svatoun/Reflexshield/board/deska.png

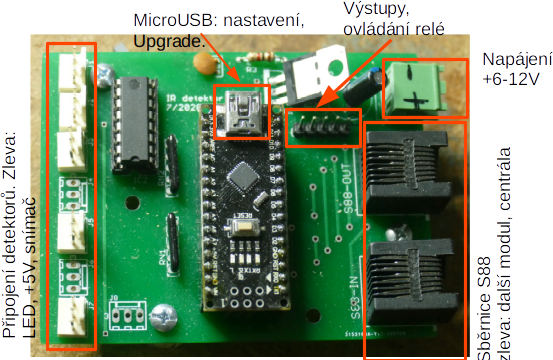
board/deska.png
