svatoun/Reflexshield/board/opto5-narrow-full2.pdf

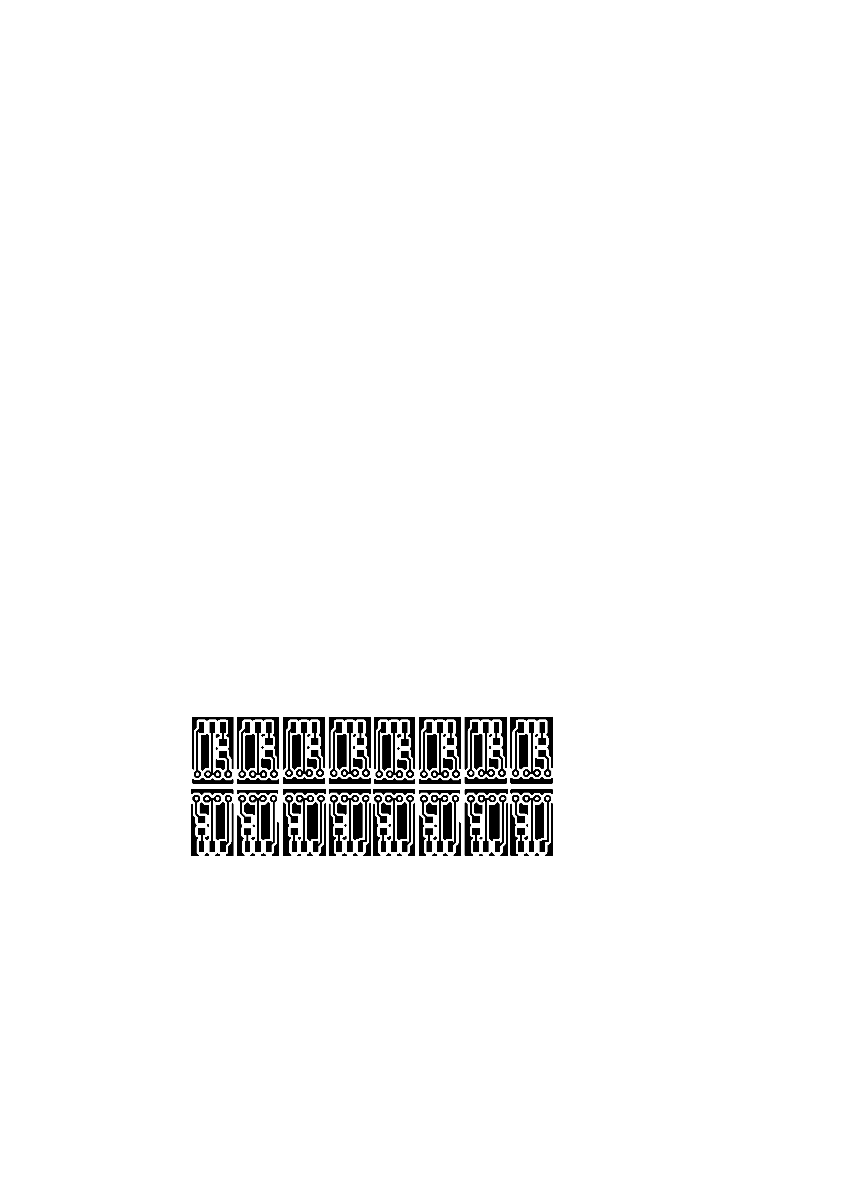
[picture p2: page 1]
