svatoun/Reflexshield/board/opto5-narrow.pdf

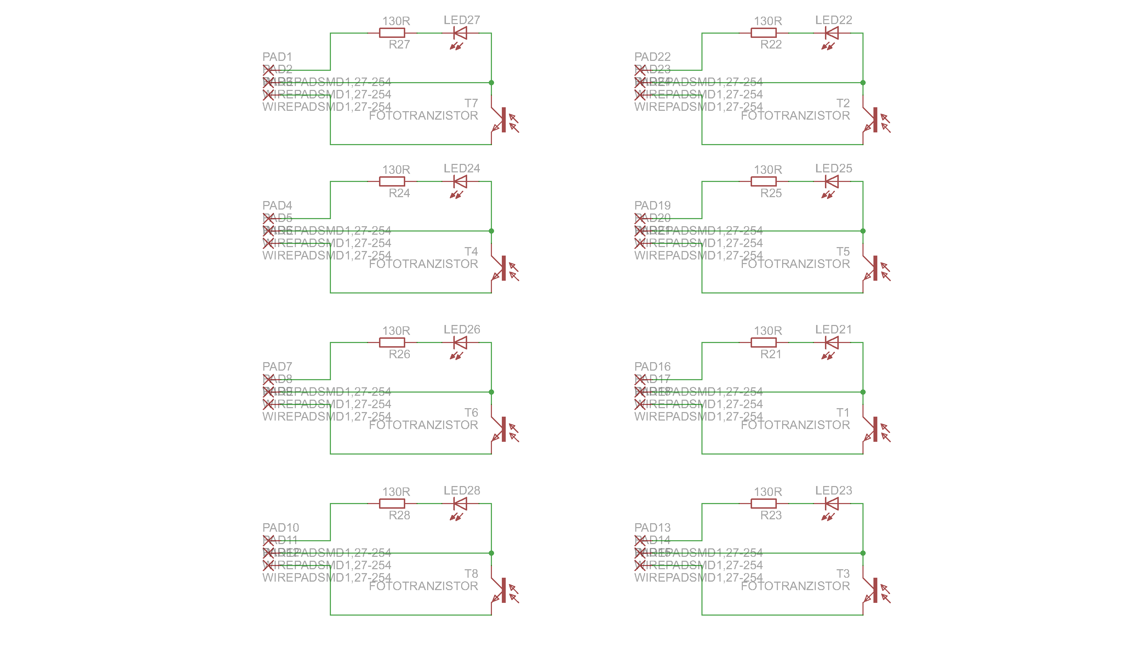
[picture p3: page 1]
