svatoun/Reflexshield/board/optoshield-low1-osaz2.pdf

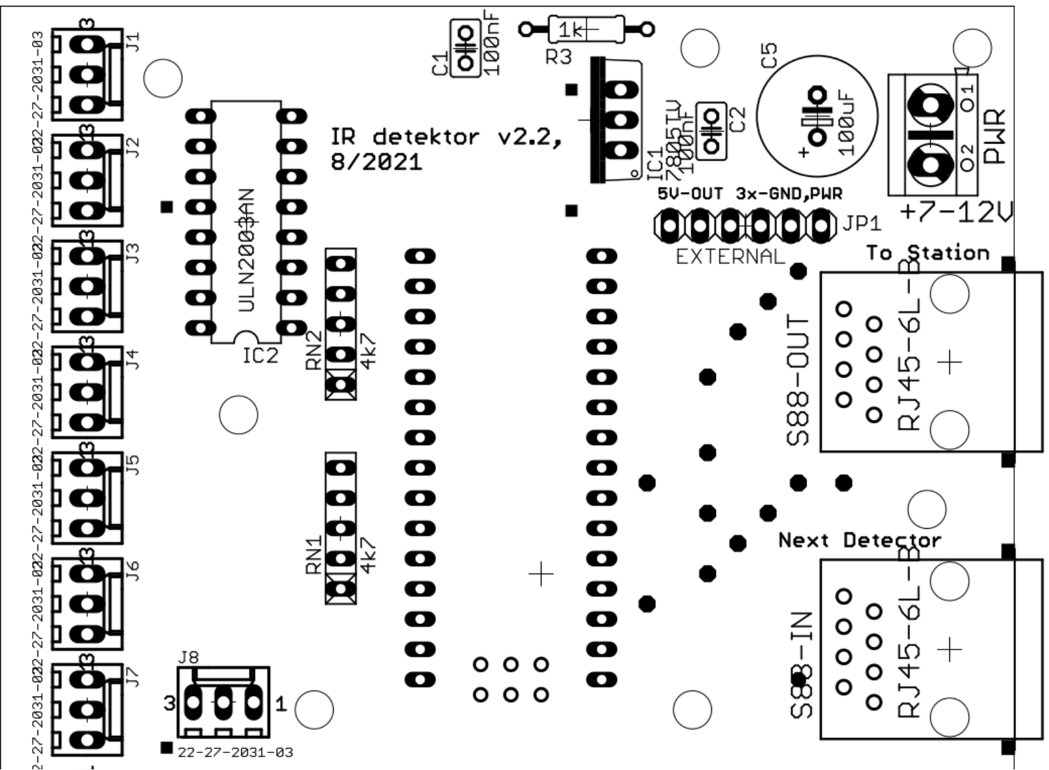
[picture p4: page 1]
