svatoun/Reflexshield/board/optoshield-low1-schema.pdf

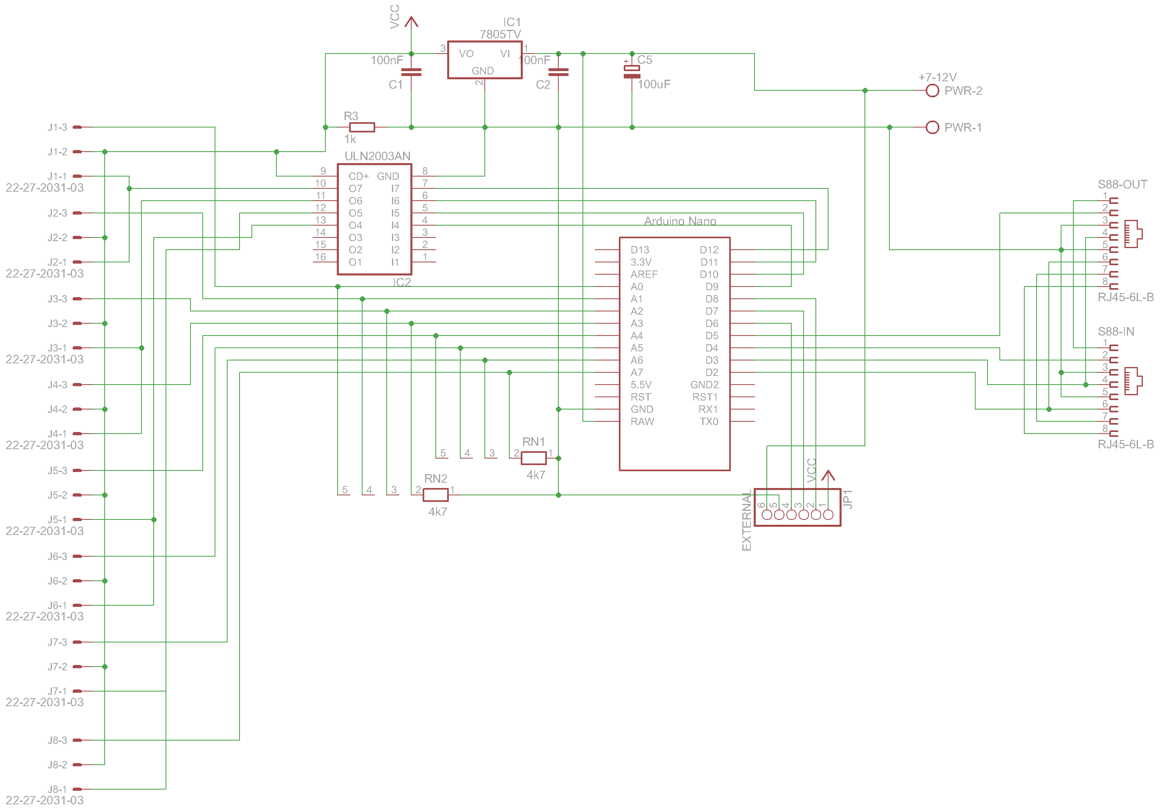
[picture p5: page 1]
