svatoun/Reflexshield/arduino/dva-senzory-enter.png

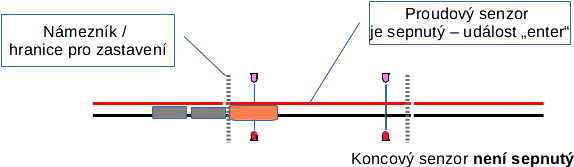
arduino/dva-senzory-enter.png
