svatoun/Reflexshield/arduino/dva-senzory-in.png

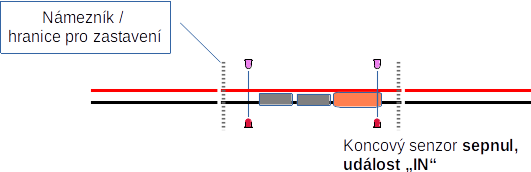
arduino/dva-senzory-in.png
