svatoun/Reflexshield/arduino/senzor-mezera.png

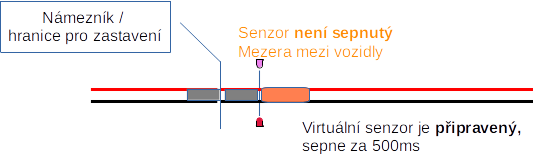
arduino/senzor-mezera.png
