svatoun/Reflexshield/arduino/senzor-najezd-soupravy.png

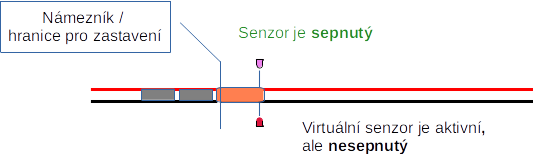
arduino/senzor-najezd-soupravy.png
