svatoun/Reflexshield/arduino/senzor-uvolnen.png

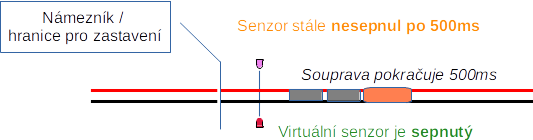
arduino/senzor-uvolnen.png
