svatoun/Reflexshield/arduino/senzor-za-poslednim.png

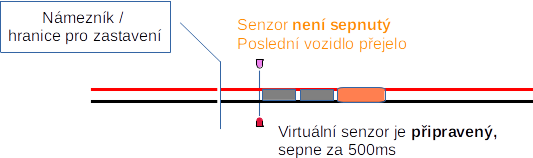
arduino/senzor-za-poslednim.png
