svatoun/Reflexshield/board/opto4-board.jpg

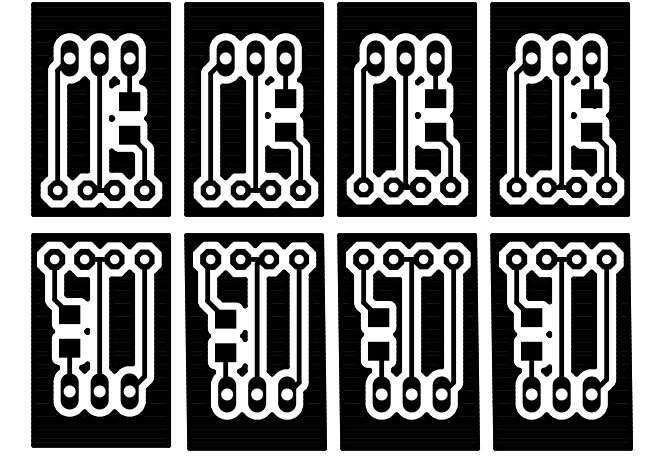
board/opto4-board.jpg
