svatoun/Reflexshield/board/opto4.png

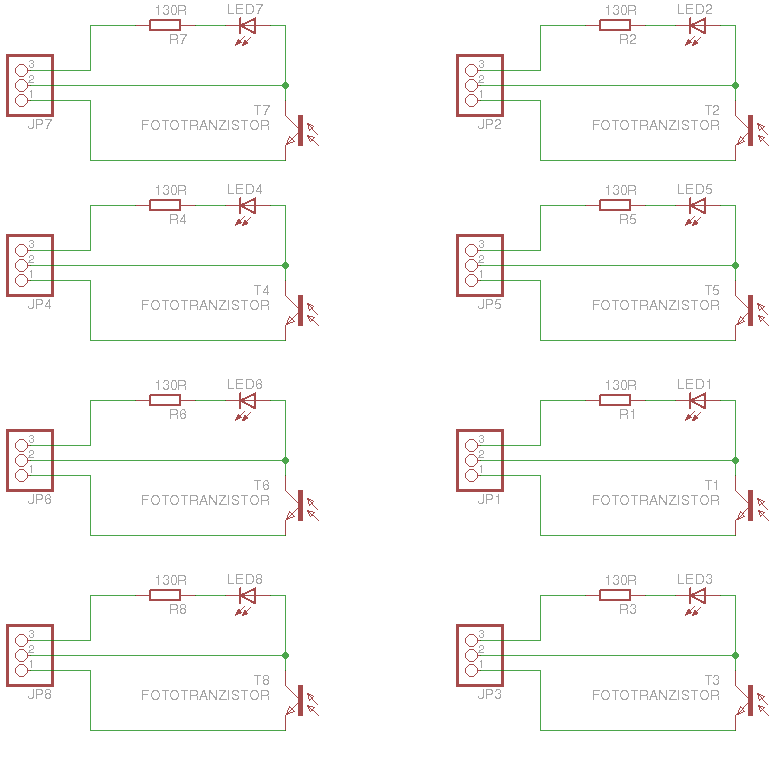
board/opto4.png
