svatoun/Reflexshield/board/optoshield-low1-board.png

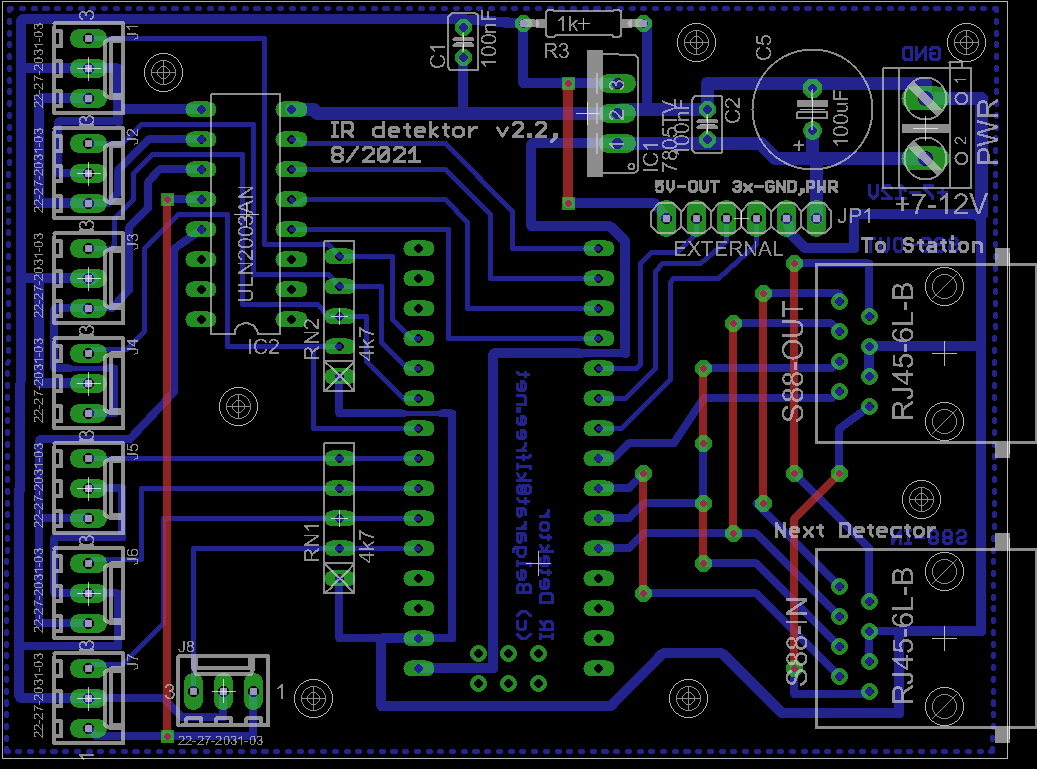
board/optoshield-low1-board.png
