svatoun/Reflexshield/board/optoshield-low1-osaz.jpg

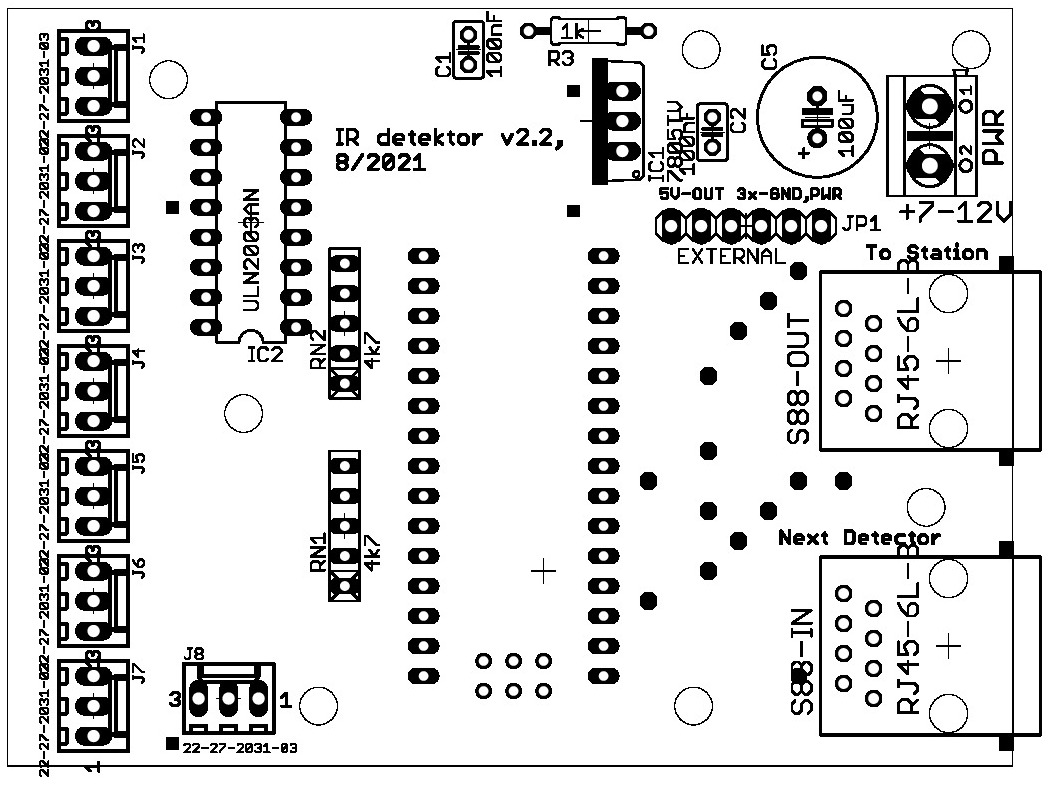
board/optoshield-low1-osaz.jpg
