svatoun/Reflexshield/board/optoshield-low1.jpg

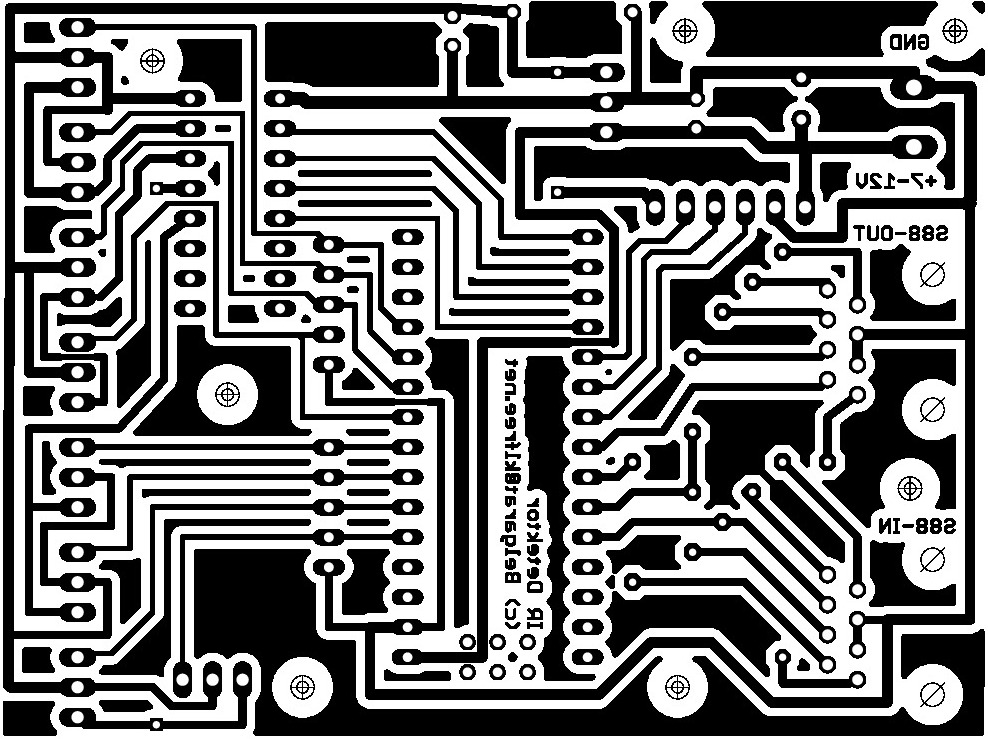
board/optoshield-low1.jpg
