svatoun/Reflexshield/board/Relayboard-board.jpg

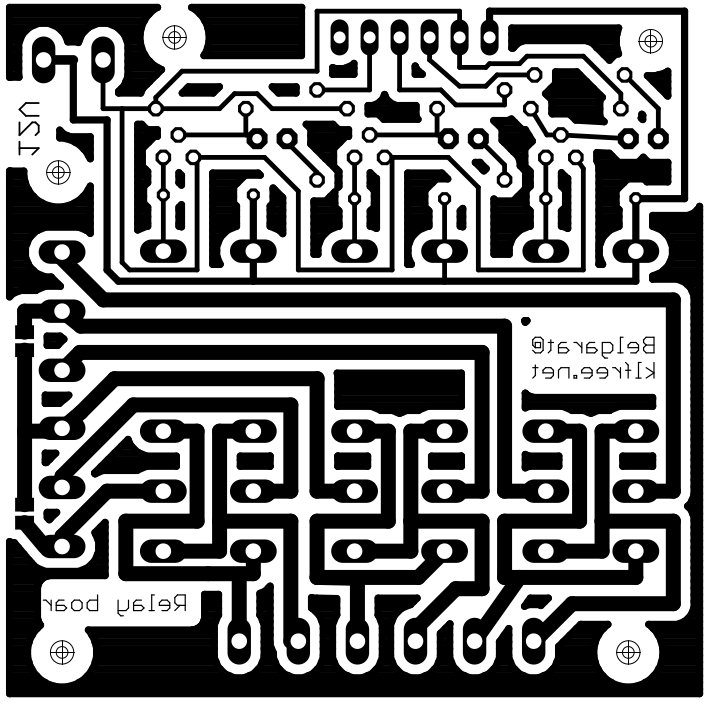
board/Relayboard-board.jpg
