svatoun/Reflexshield/board/Relayboard-schema.png

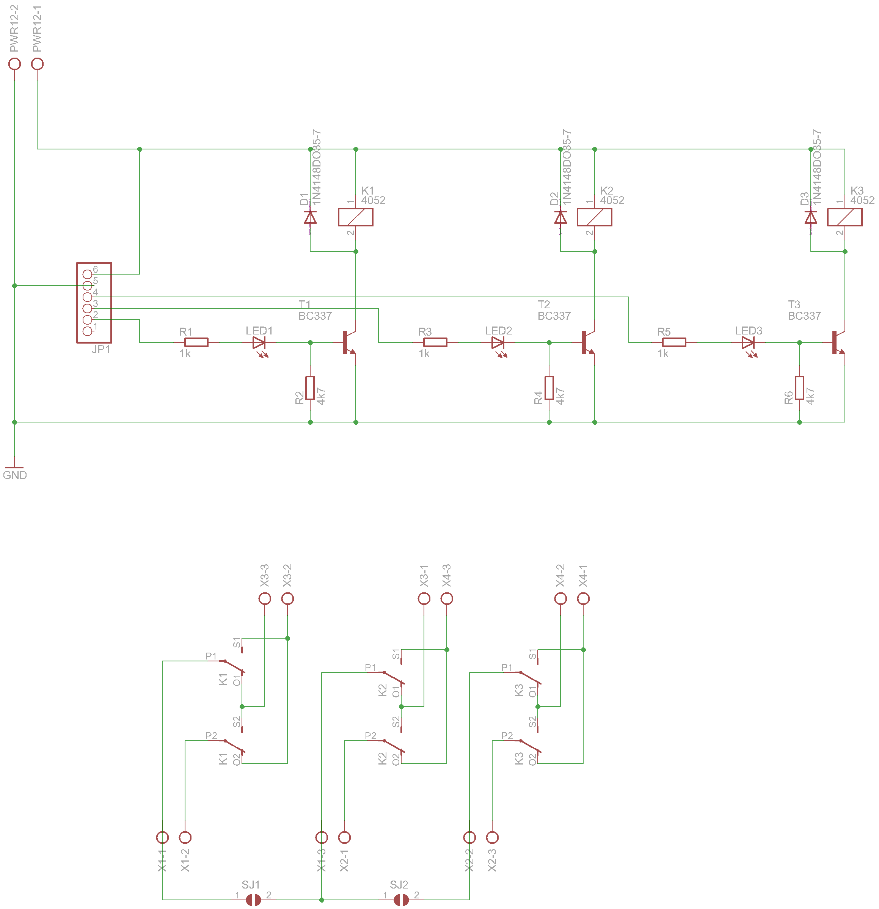
board/Relayboard-schema.png
