svatoun/Reflexshield/board/optoshield-low1.pdf

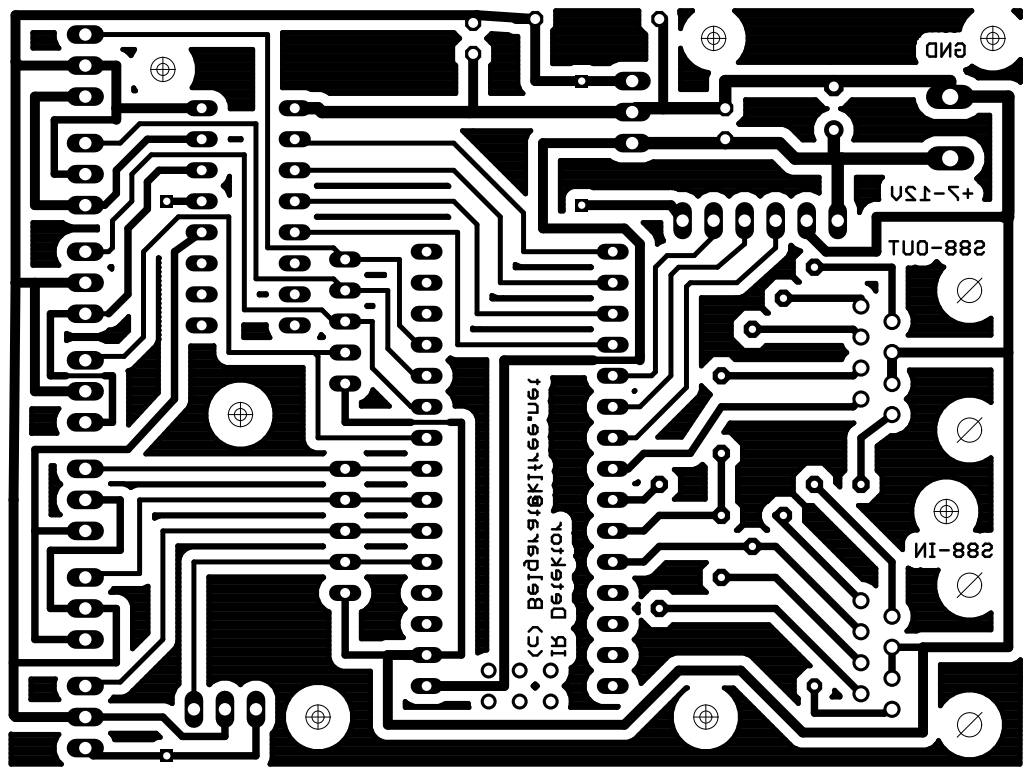
[picture p19: page 1]
