svatoun/Reflexshield/board/Relayboard.pdf

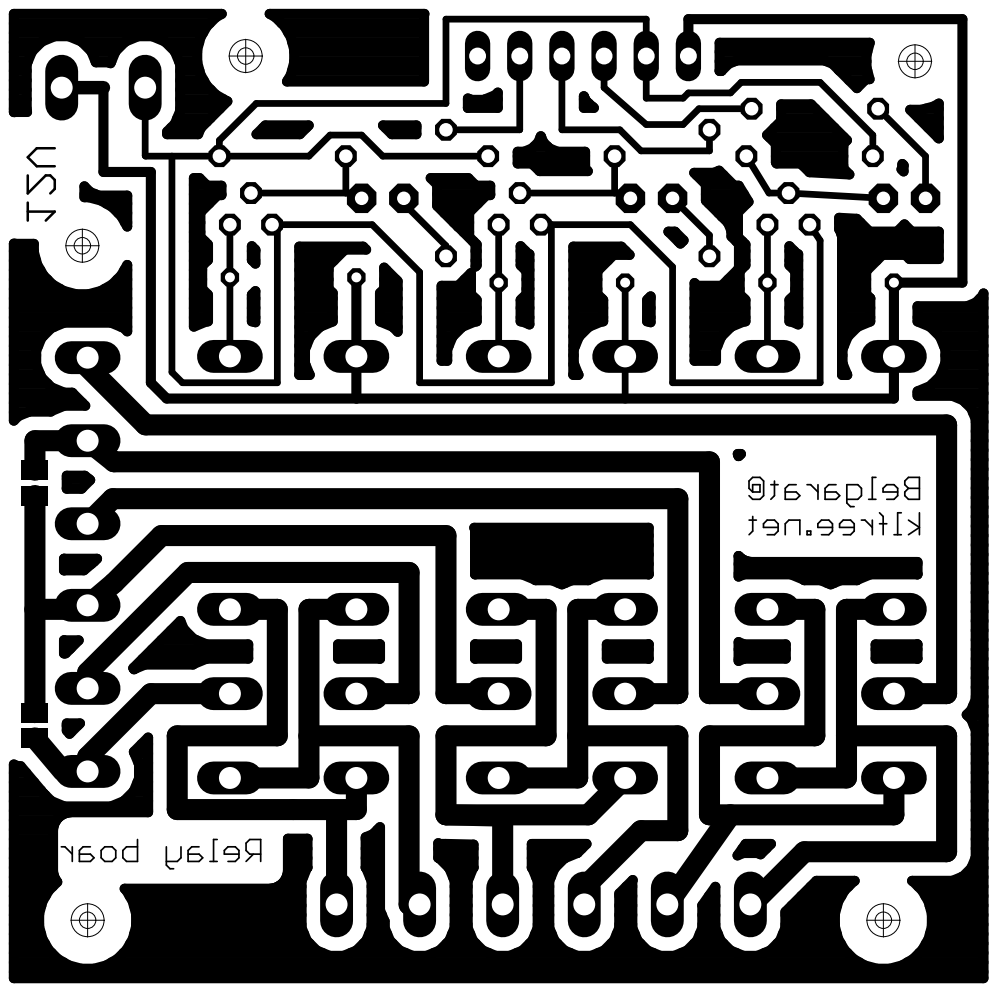
[picture p20: page 1]
