svatoun/Reflexshield/board/opto4-osaz.pdf

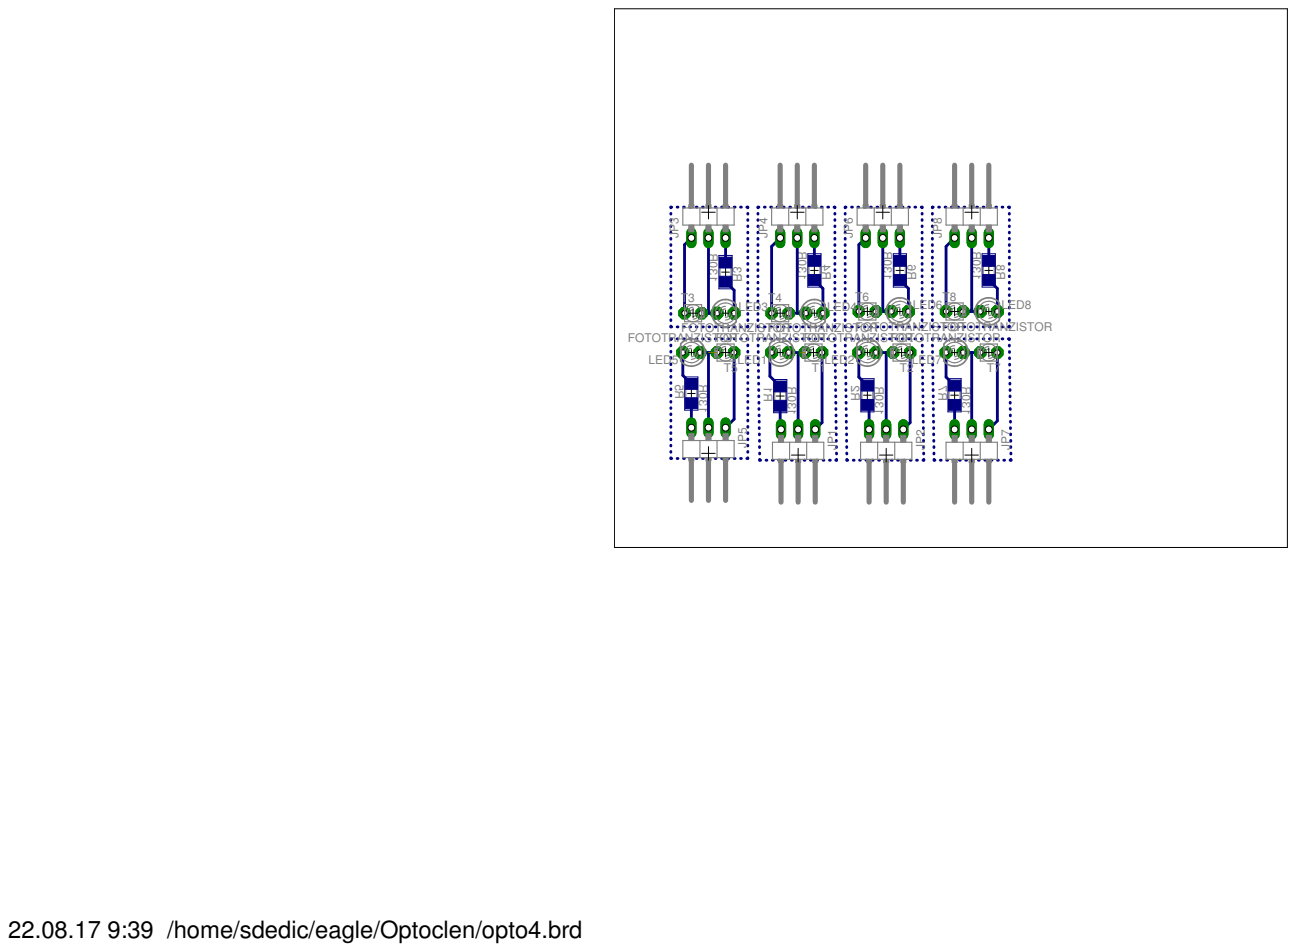
[picture p21: page 1]

22.08.17 9:39 /home/sdedic/eagle/Optoclen/opto4.brd
