svatoun/Reflexshield/board/opto4.pdf

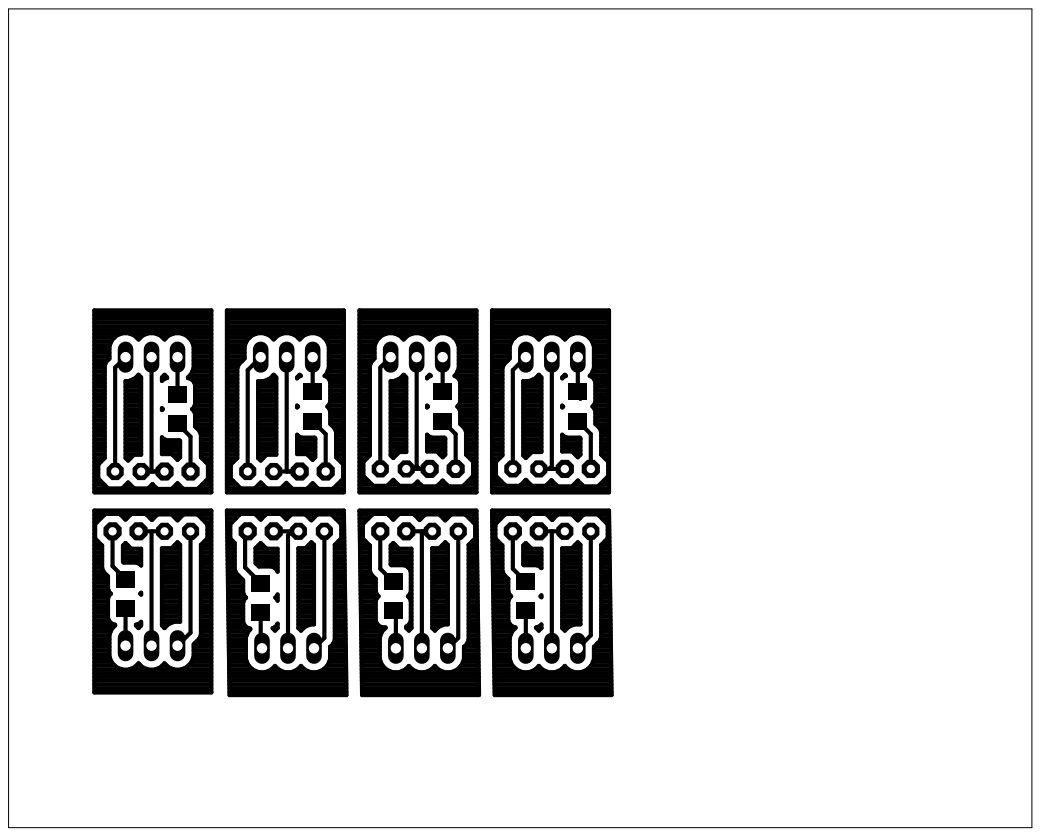
[picture p22: page 1]
