svatoun/Reflexshield/eagle/optoshield-low1.brd

## EAGLE design eagle/optoshield-low1.brd (2021-09-28)

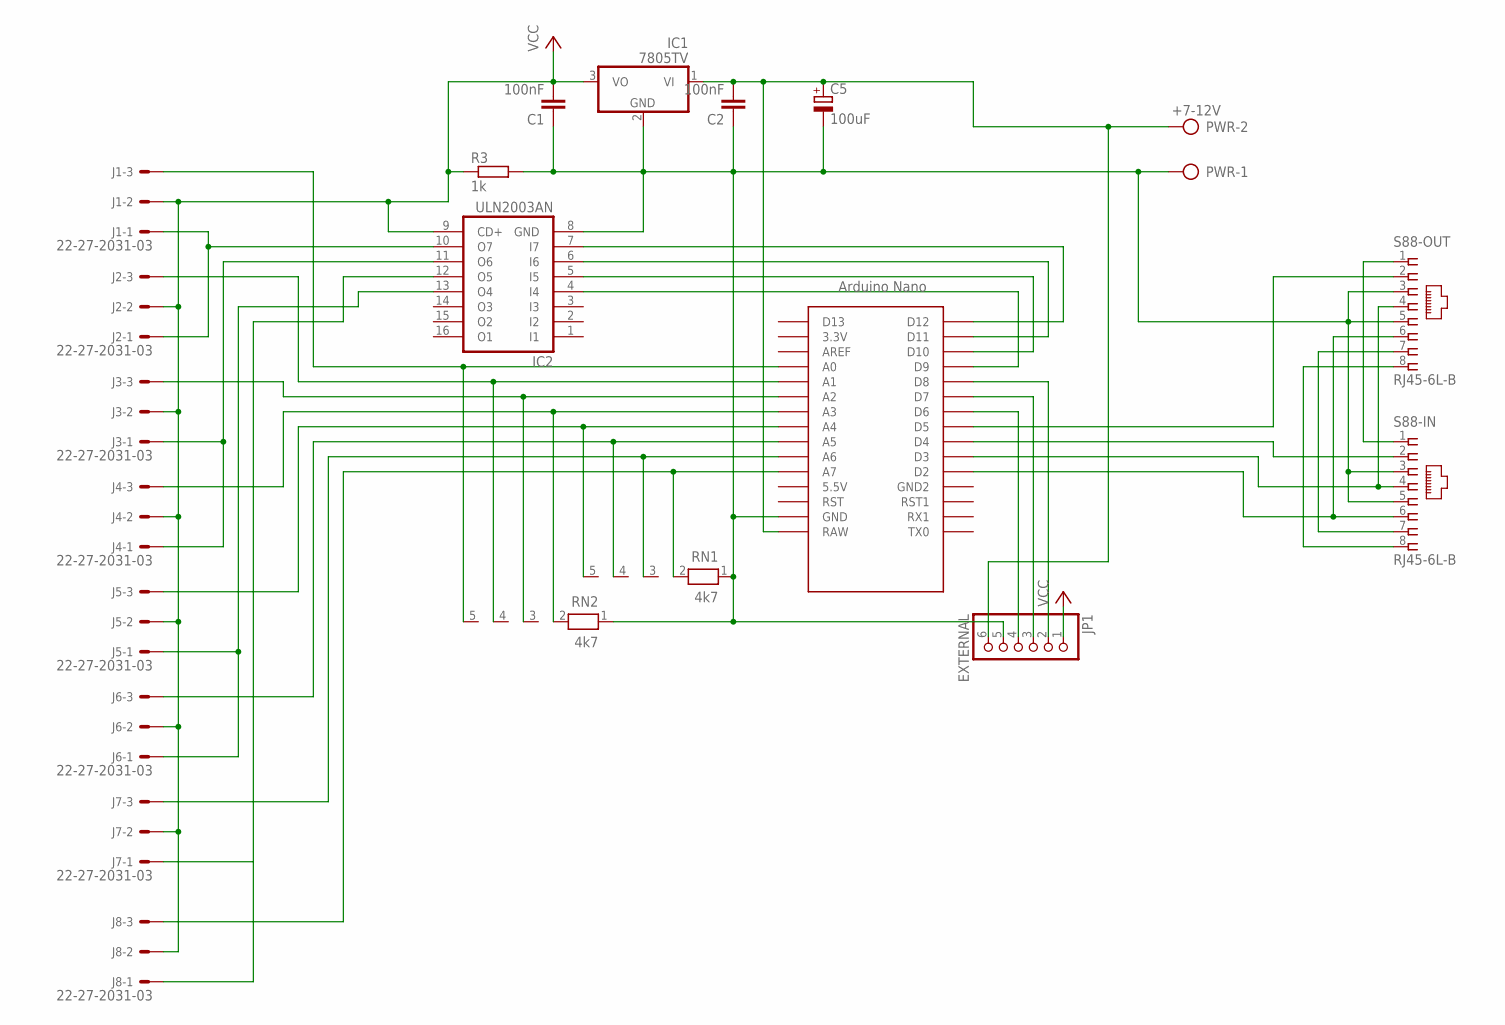
[picture p23: schematic optoshield-low1.sch]

Parts:
C1, C2: 100nF; C025-025X050
C5: 100uF; E3,5-10
IC1: 7805TV; TO220V
IC2: ULN2003AN; DIL16
J1, J2, J3, J4, J5, J6, J7, J8: 22-27-2031-03; 6410-03
JP1: EXTERNAL; 1X06
PWR: +7-12V; AK500/2
R3: 1k; 0207/10
RN1, RN2: 4k7; RN-5
S88-IN, S88-OUT: RJ45-6L-B; RJ45-NO-SHIELD
U$1: NANO

Connections:
GND: C1.1, C2.1, C5.-, IC1.2 (GND), IC2.8 (GND), JP1.5, PWR.1, R3.2, RN1.1, RN2.1, S88-IN.3, S88-IN.5, S88-OUT.3, S88-OUT.5, U$1.GND
unnamed: C2.2, C5.+, IC1.1 (VI), JP1.6, PWR.2, U$1.RAW
unnamed: S88-IN.1, S88-OUT.1
unnamed: JP1.2, U$1.D8
unnamed: J1.3, RN2.5, U$1.A0
unnamed: J4.3, RN2.2, U$1.A3
unnamed: J5.3, RN1.5, U$1.A4
unnamed: J2.3, RN2.4, U$1.A1
unnamed: J3.3, RN2.3, U$1.A2
unnamed: J6.3, RN1.4, U$1.A5
unnamed: J7.3, RN1.3, U$1.A6
unnamed: J8.3, RN1.2, U$1.A7
unnamed: JP1.3, U$1.D7
unnamed: S88-IN.8, S88-OUT.8
unnamed: S88-IN.6, S88-OUT.6, U$1.D2
unnamed: IC2.7 (I7), U$1.D12
unnamed: S88-IN.7, S88-OUT.7
unnamed: S88-IN.4, S88-OUT.4, U$1.D3
unnamed: S88-IN.2, U$1.D4
unnamed: IC2.12 (O5), J7.1, J8.1
unnamed: S88-OUT.2, U$1.D5
unnamed: IC2.6 (I6), U$1.D11
unnamed: IC2.5 (I5), U$1.D10
unnamed: IC2.4 (I4), U$1.D9
unnamed: JP1.4, U$1.D6
unnamed: IC2.10 (O7), J1.1, J2.1
unnamed: IC2.11 (O6), J3.1, J4.1
unnamed: IC2.13 (O4), J5.1, J6.1
VCC: C1.2, IC1.3 (VO), IC2.9 (CD+), J1.2, J2.2, J3.2, J4.2, J5.2, J6.2, J7.2, J8.2, JP1.1, R3.1

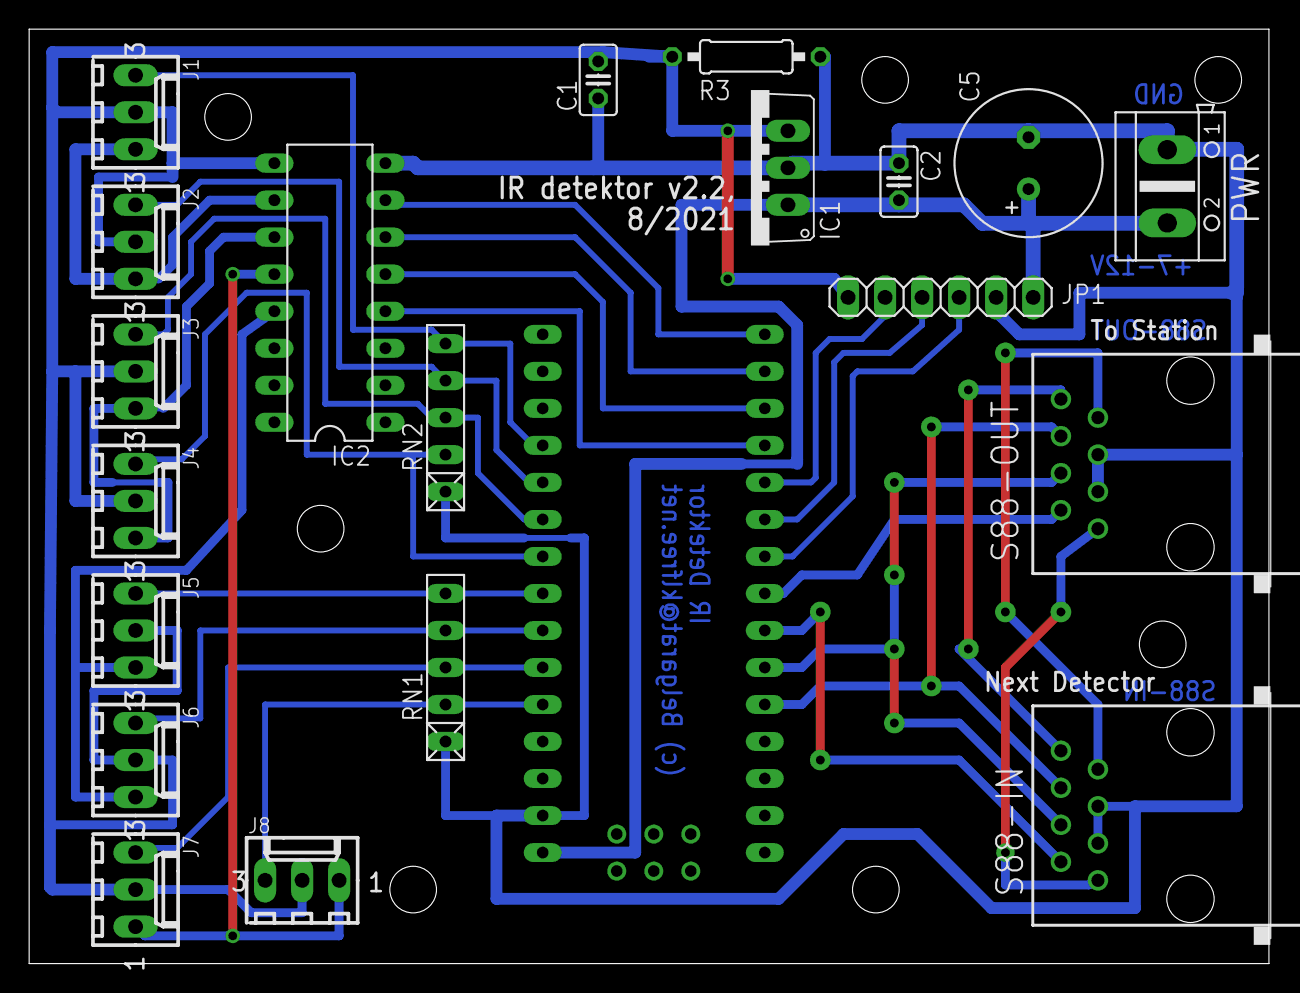
[picture p24: board optoshield-low1.brd from above]

Board: 2 copper layers, 85.1 x 64.1 mm, 21 parts (0 on the bottom side), 29 nets.
