svatoun/Reflexshield/arduino/ReflexShield/Settings.h

#ifndef __settings_h__
#define __settings_h__


extern const int blinkConfig[];
extern const int blinkConfigEnd[];
extern const int blinkShort[];
extern const int blinkLong[];
extern const int blinkTwice[];
extern const int blinkThrice[];
extern const int blinkCalibrateLow[];
extern const int blinkCalibrateCont[];
extern const int blinkCalibrateEnd[];
extern const int blinkReset[];

extern long plusButtonStart;
extern long minusButtonStart;
extern long nextButtonStart;
extern int plusLen;
extern int minusLen;
extern int nextLen;

extern boolean terminalConfirm;
extern boolean terminalCalibration;

#endif
