svatoun/Reflexshield/(commit log)

2017-08-22 Initial sketch and board files
    [control.brd, control.sch, opto4.brd, opto4.sch, optoshield3.brd, optoshield3.sch]
2021-07-20 Relays added.
2021-09-23 Zruseny stary design eagle
    [control.brd, control.sch, opto4.brd, opto4.sch, optoshield3.brd, optoshield3.sch]
2021-09-28 DPS v3.0
    [optoshield-low1.brd, optoshield-low1.sch]
