svatoun/Reflexshield/(notices)

Notices in the files:
arduino/ReflexShield/ReflexShield.ino:
modify it under the terms of the GNU General Public License
